RmnRss/Merite_FAE/Protocoles_lancements/Protocole_lancement_fusees.pdf

PROTOCOLE DE LANCEMENT DES FUSÉES A EAU

1

PREMIER LANCER APRES AVOIR ALLUMÉ LA CARTE

1. Une fois la carte allumée, attendez que la LED ROUGE clignote.
2. Quand la LED ROUGE clignote, enfoncez le parachute de manière que la tige dépasse du bas de la fusée (voir photo 1).
3. Gardez le parachute enfoncé et appuyez sur le bouton pour verrouiller le parachute.
4. Une fois le parachute verrouillé (photo 2), attendez que la LED ROUGE clignote à nouveau.
5. Placez la fusée dans le lanceur en ouvrant le diaphragme en appuyant sur le bouton rouge en bas à gauche du lanceur.
6. Une fois la fusée placée. Rappuyer sur le bouton la LED ROUGE devrait alors s’éteindre et la LED VERTE s’allumer.
7. Une fois la LED VERTE allumée, vous êtes prêt à lancer.

POUR LES LANCERS SUIVANT SUIVRE LE MEME PROTOCOLE AVEC UN APPUI SUPPLEMENTAIRE AU DEPART.

PROTOCOLE DE LANCEMENT DES FUSÉES A EAU

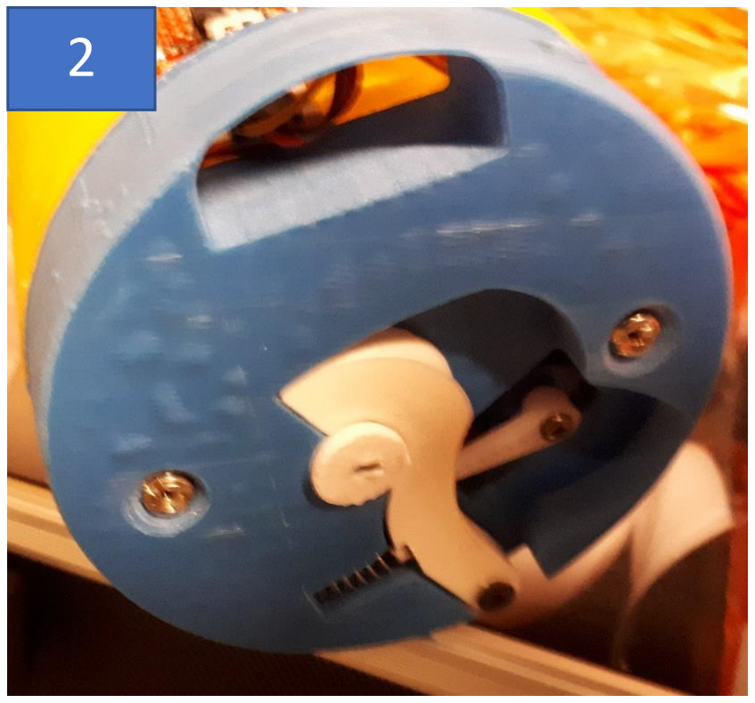
[picture p1: figure]

2

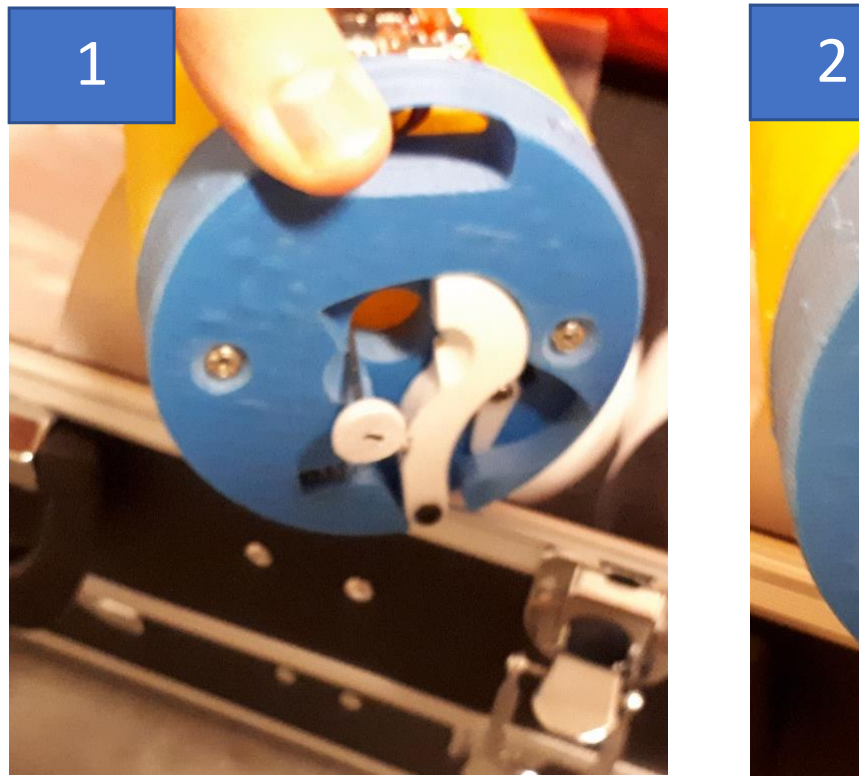
[picture p2: figure]
