RmnRss/Merite_FAE/Exploitation_Donnees/01_Matlab/ensim.png

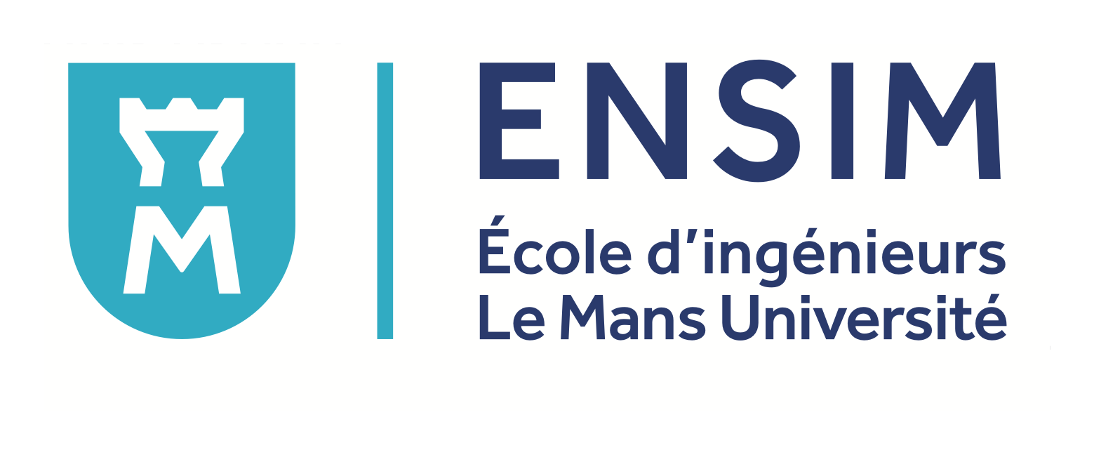
Exploitation_Donnees/01_Matlab/ensim.png
