RmnRss/Merite_FAE/Exploitation_Donnees/01_Matlab/merite.png

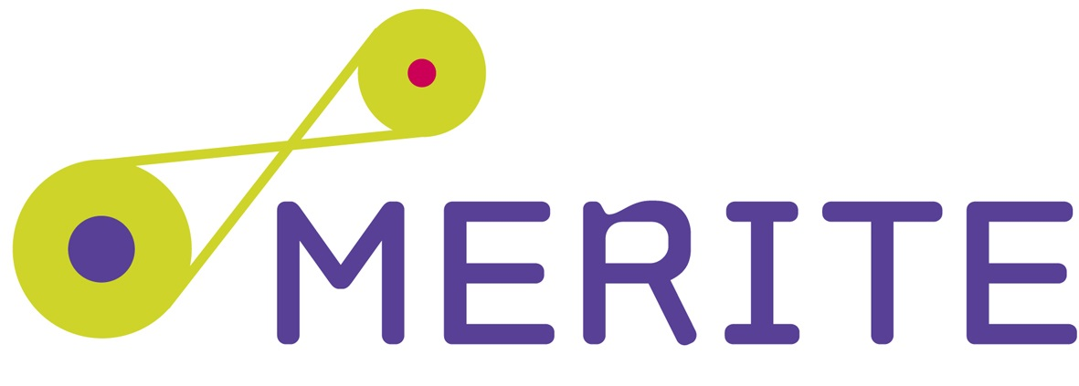
Exploitation_Donnees/01_Matlab/merite.png
