RmnRss/Merite_FAE/Exploitation_Donnees/03_Python_Alt_Only/main_page_paint.png

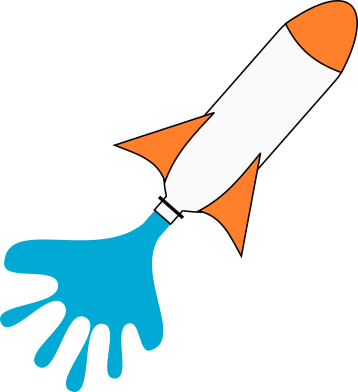
Exploitation_Donnees/03_Python_Alt_Only/main_page_paint.png
