RmnRss/Merite_FAE/Doc_3D_Fusees/Bras de verrouillage.stl

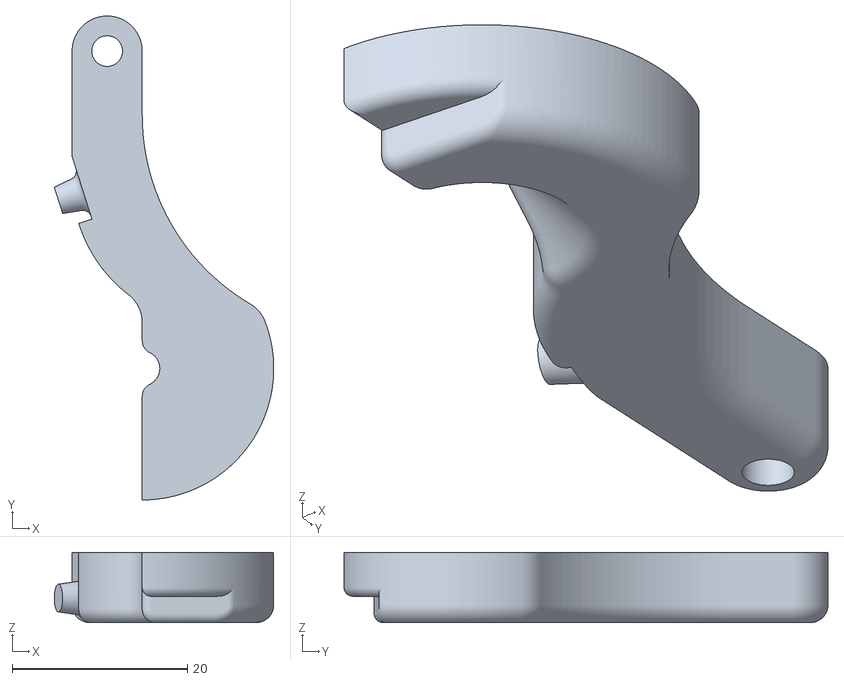
[picture p6: CAD file, 2018-06-28]
Doc_3D_Fusees/Bras de verrouillage.stl
25.0 x 55.2 x 8.00
