RmnRss/Merite_FAE/Doc_3D_Fusees/Demi-sphère.stl

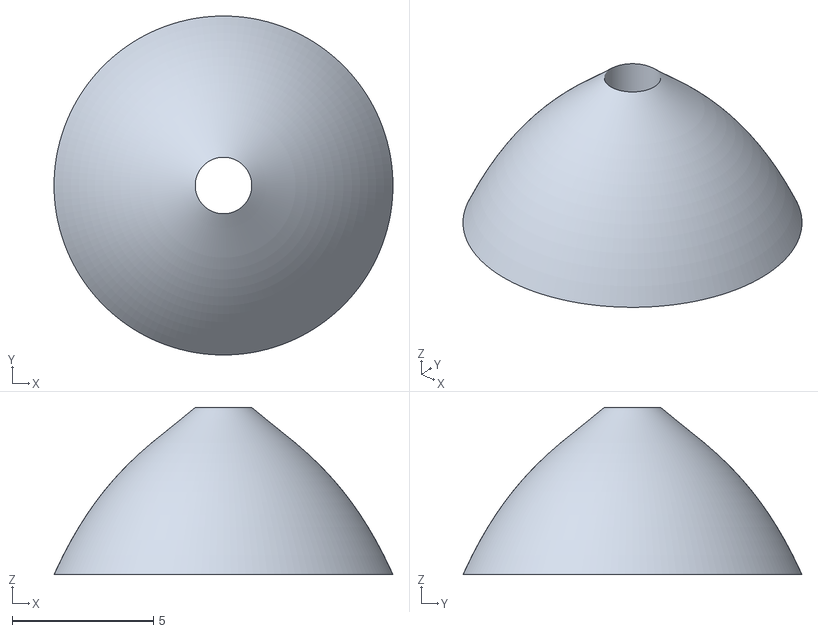
[picture p7: CAD file, 2018-06-28]
Doc_3D_Fusees/Demi-sphère.stl
12.0 x 12.0 x 5.92
