RmnRss/Merite_FAE/Doc_3D_Fusees/Base.STL

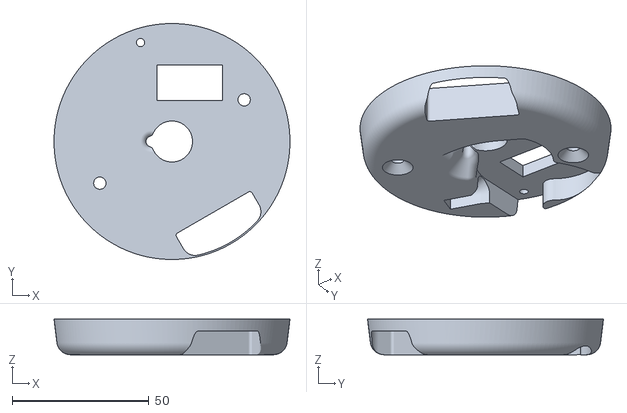
[picture p8: CAD file, 2018-06-28]
Doc_3D_Fusees/Base.STL
86.4 x 86.4 x 13.0
