RmnRss/Merite_FAE/Doc_Carte_Fusee_V2/PCB/Instructions_Fabrications.pdf

INSTRUCTION CONCEPTION TYPON CARTES FUSEES A EAU

### 1 – Fabrication

Carte à fabriquer dans ce sens :

2 – Perçage.

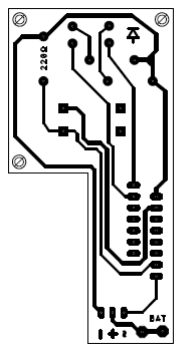
[picture p9: figure]

Toutes les pastilles sont à percer avec du 1 mm sauf les pastilles carrées à percer avec du 1.2 mm

### 3 – Soudures

Liste des éléments à souder :

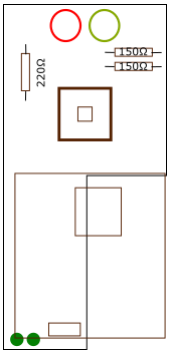
[picture p10: figure]

- 1 LED Rouge
- 1 LED Verte
- 1 résistance de 220 ohms
- 2 résistances de 150 ohms
- 1 bouton poussoir
- 1 carte Sparkfun Razor 9dof M0
- Le fil rouge de la batterie

Retourner la carte de manier à cacher les pistes et souder dans la disposition indiquée par le schéma à droite.

Pour le fil de la batterie, sectionner le fil rouge puis souder l’extrémité connectée à la batterie sur la pastille la plus à gauche dans l’angle inferieure gauche de la carte. Souder la partie du fil rouge toujours connectée à l’adaptateur à la pastille la plus à droite.
