RmnRss/Merite_FAE/Doc_Carte_Fusee_V2/PCB/Typon_V2_1.pdf

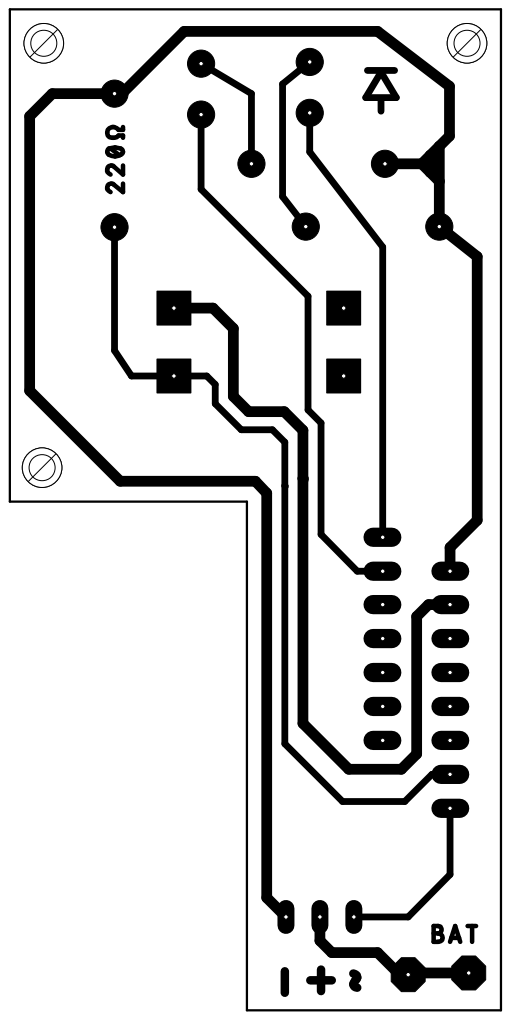
[picture p11: page 1]
