RmnRss/Merite_FAE/Doc_Carte_Fusee_V2/PCB/Projet EAGLE/Carte_FAE_V2_1/FAE_V2_1.brd

## EAGLE design Doc_Carte_Fusee_V2/PCB/Projet EAGLE/Carte_FAE_V2_1/FAE_V2_1.brd (2018-07-13)

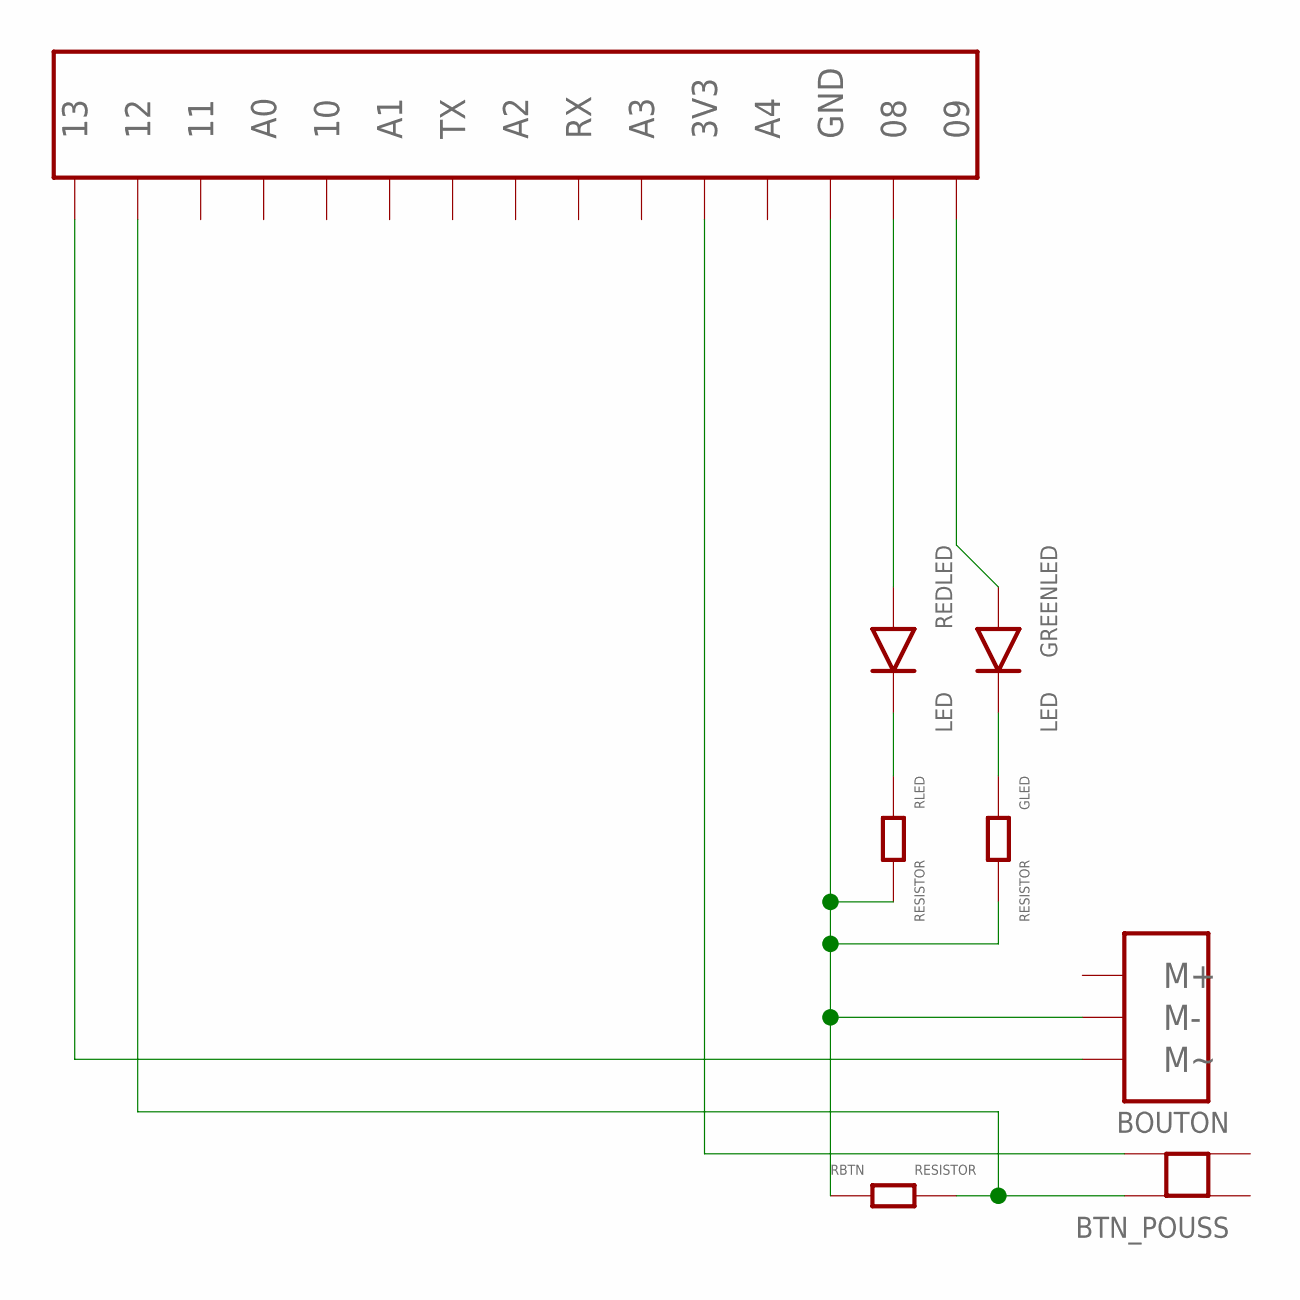
[picture p12: schematic FAE_V2_1.sch]

Parts:
BTN_POUSS: BOUTON
GLED: RESISTOR
GREENLED: LED
RBTN: RESISTOR
REDLED: LED
RLED: RESISTOR
U$1: RAZOR_BOARD
U$3: SERVO_ADAPT

Connections:
unnamed: GREENLED.IN, U$1.09
unnamed: GLED.A, GREENLED.OUT
unnamed: BTN_POUSS.D, U$1.3V3
unnamed: BTN_POUSS.C, RBTN.B, U$1.12
unnamed: U$1.13, U$3.M~
unnamed: GLED.B, RBTN.A, RLED.B, U$1.GND, U$3.M-
unnamed: REDLED.IN, U$1.08
unnamed: REDLED.OUT, RLED.A

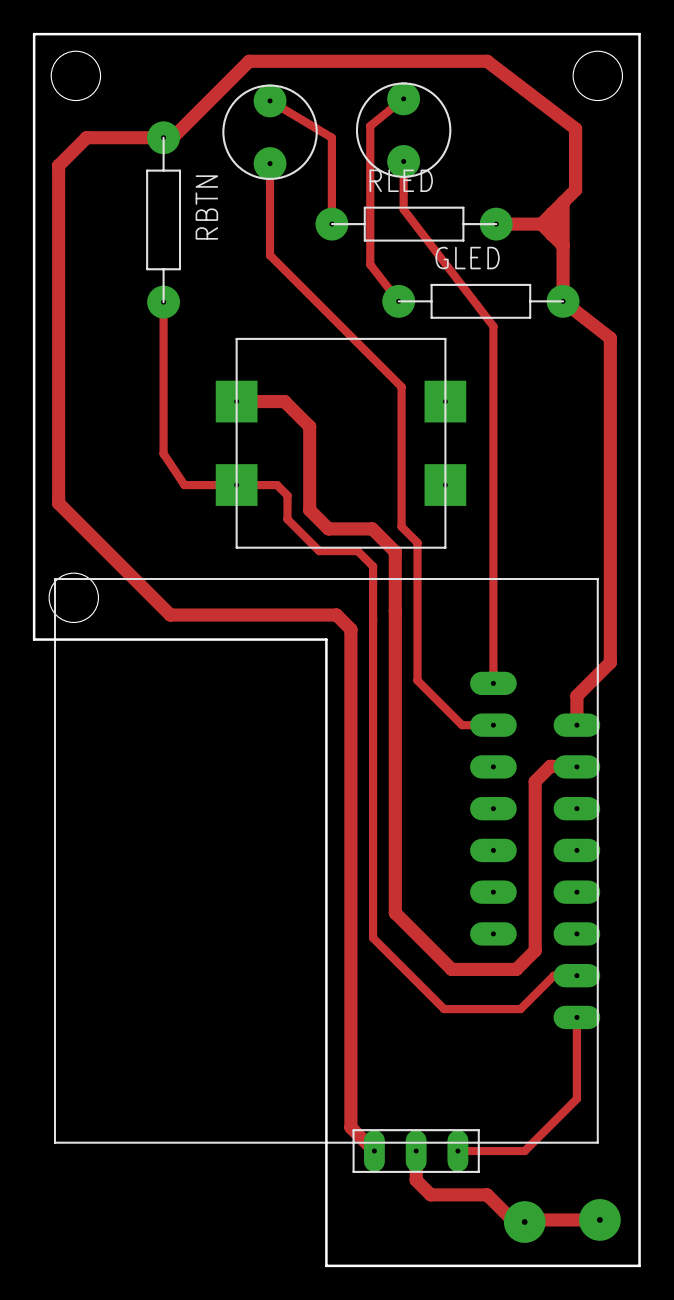
[picture p13: board FAE_V2_1.brd from above]

Board: 2 copper layers, 36.8 x 74.9 mm, 8 parts (0 on the bottom side), 8 nets.
