RmnRss/Merite_FAE/Doc_Carte_Fusee_V2/PCB/Projet EAGLE/Carte_FAE/FAE.brd

## EAGLE design Doc_Carte_Fusee_V2/PCB/Projet EAGLE/Carte_FAE/FAE.brd (2018-06-28)

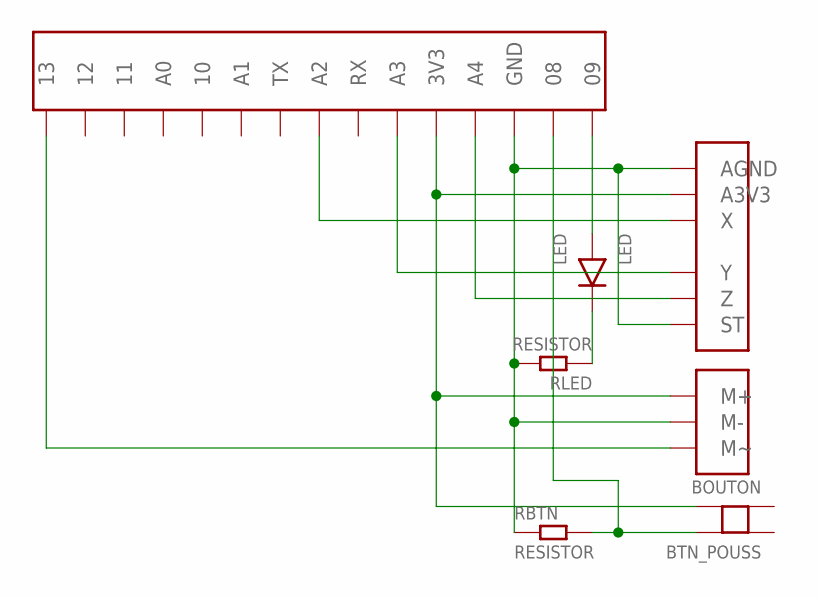
[picture p14: schematic FAE.sch]

Parts:
BTN_POUSS: BOUTON
LED: LED
RBTN: RESISTOR
RLED: RESISTOR
U$1: RAZOR_BOARD
U$2: ADXL377
U$3: SERVO_ADAPT

Connections:
unnamed: LED.IN, U$1.09
unnamed: LED.OUT, RLED.A
unnamed: RBTN.A, RLED.B, U$1.GND, U$2.AGND, U$2.ST, U$3.M-
unnamed: BTN_POUSS.D, U$1.3V3, U$2.A3.3V (A3V3), U$3.M+
unnamed: BTN_POUSS.C, RBTN.B, U$1.08
unnamed: U$1.13, U$3.M~
unnamed: U$1.A2, U$2.X
unnamed: U$1.A3, U$2.Y
unnamed: U$1.A4, U$2.Z

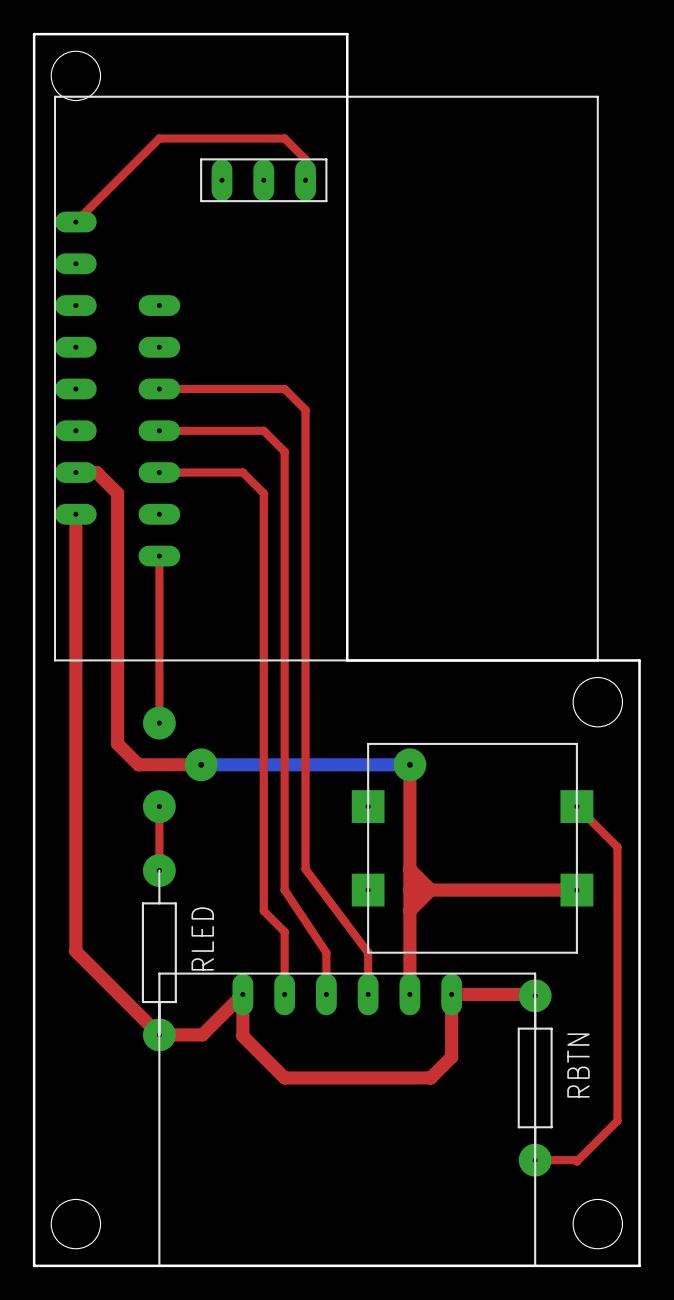
[picture p15: board FAE.brd from above]

Board: 2 copper layers, 36.8 x 74.9 mm, 7 parts (0 on the bottom side), 9 nets.
