RmnRss/Merite_FAE/(commit log)

2018-06-28 Nettoyage Update Ajouts
    [Base.STL, Bras de verrouillage.stl, Demi-sphère.stl, FAE.brd, FAE.sch]
2018-07-11 Ajouts 11/07
    Code BME_ONLY
    Fichiers Lancers
    Exploitation en Python
    [LANCER_0.CSV, LANCER_1.CSV, LANCER_2.CSV, LANCER_3.CSV, LANCER_4.CSV, LANCER_5.CSV, LANCER_6.CSV, LANCER_9.CSV]
2018-07-13 Fin_Stage
    Fusée Altimètre Seul
    Ajout Python
    Exe Non fonctionnel
    [FAE_V2_1.brd, FAE_V2_1.sch, LANCER_0.CSV, LANCER_1.CSV, LANCER_2.CSV, LANCER_3.CSV, LANCER_4.CSV, LANCER_5.CSV]
2018-09-12 Clean code
    Exploitation des données sans vitesse
    [data_x_x2_x3.csv, demodata.csv, msft.csv, percent_bachelors_degrees_women_usa.csv]
